TurpinL/radial-sequencer/KiCad/Radial Sequencer Test Board 1/Radial Sequencer Test Board 1.kicad_pcb

## KiCad design KiCad/Radial Sequencer Test Board 1/Radial Sequencer Test Board 1.kicad_pcb (2025-02-18)

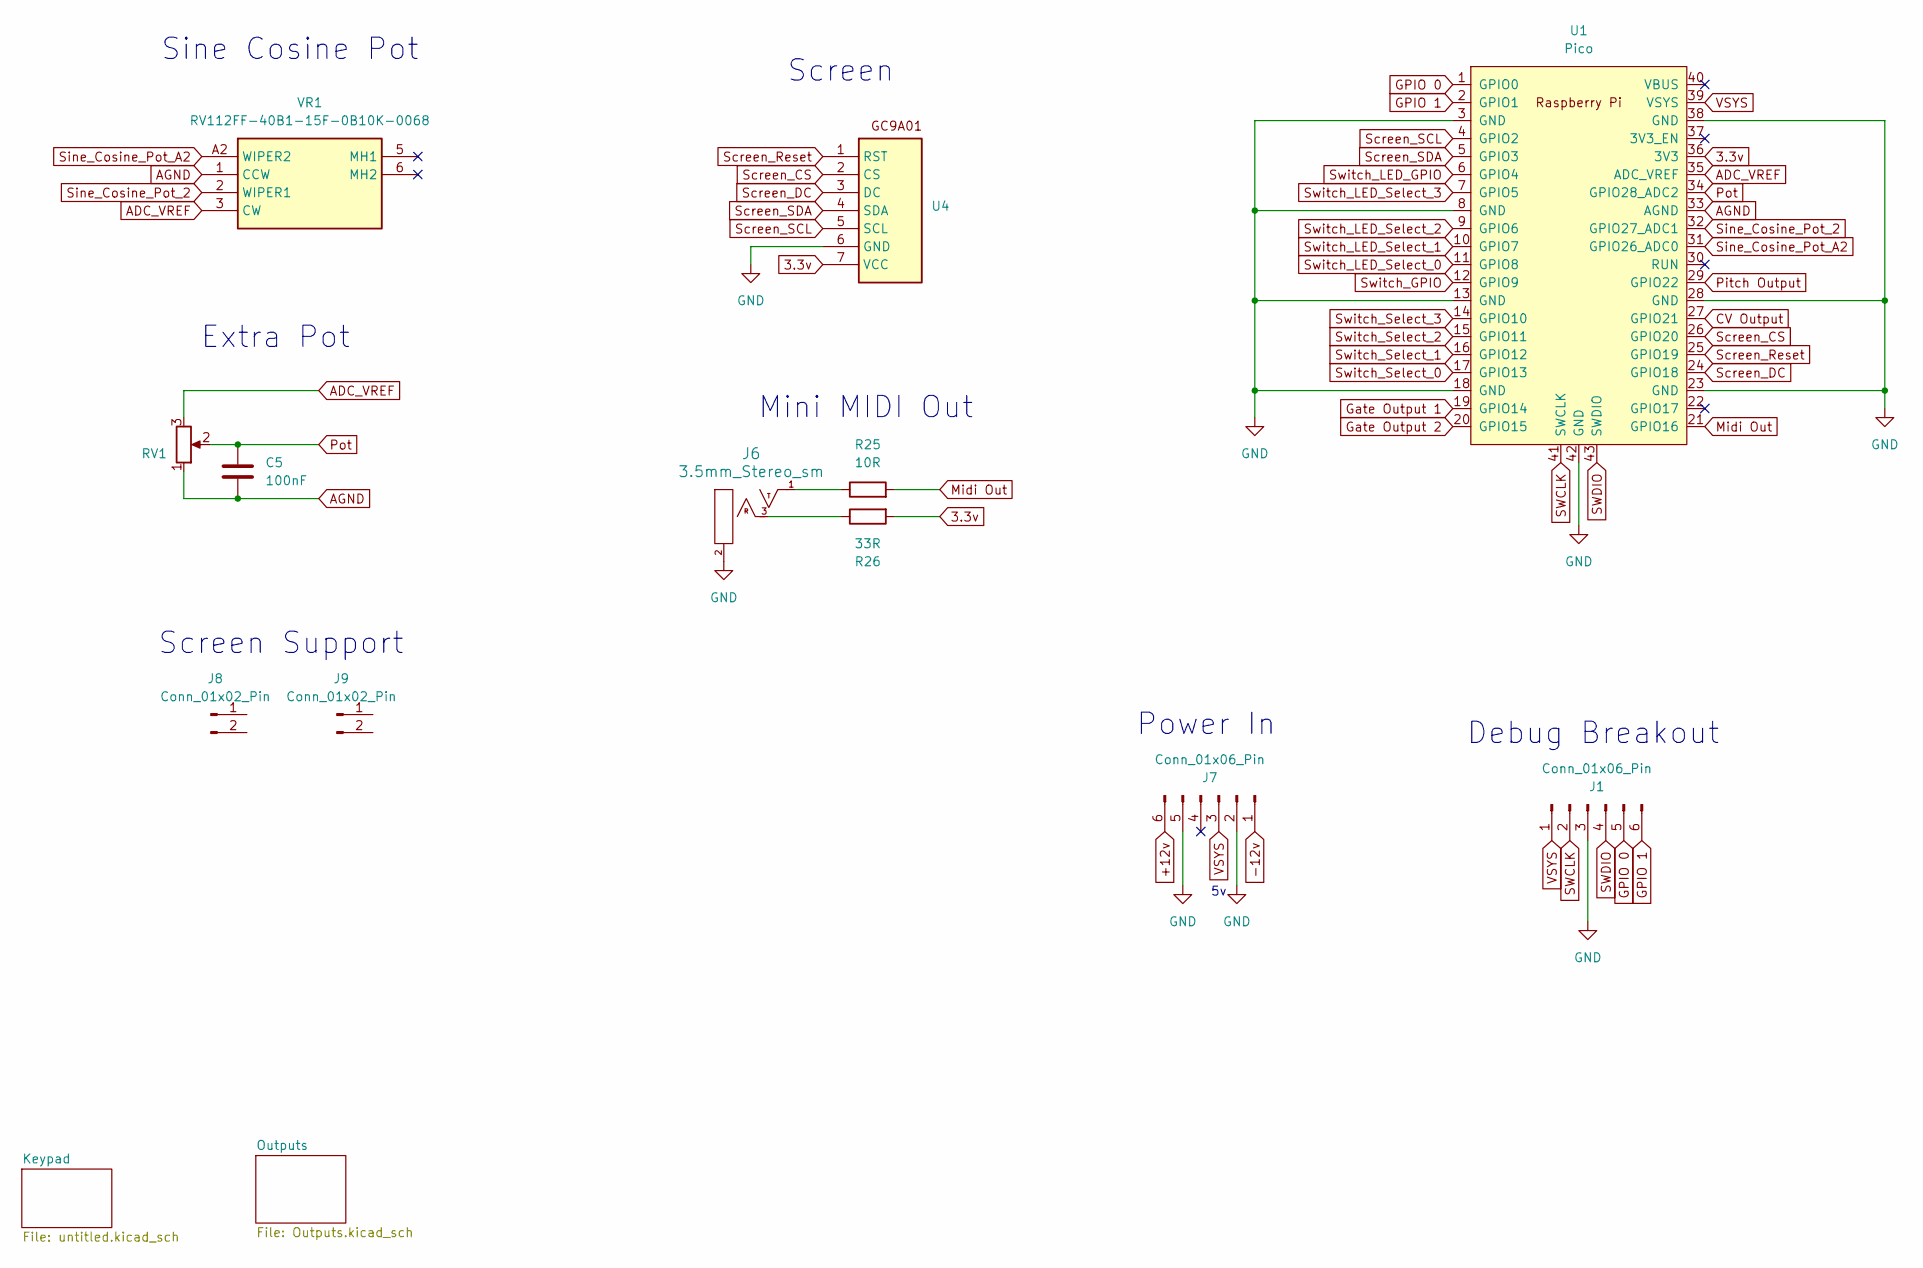
[picture p1: schematic Radial Sequencer Test Board 1.kicad_sch]

Parts:
C5: 100nF; C_0805_2012Metric_Pad1.18x1.45mm_HandSolder
J1, J7: Conn_01x06_Pin; PinHeader_1x06_P2.54mm_Vertical
J6: 3.5mm_Stereo_sm; EighthInch_Stereo_PJ366ST; Part Number WQP-WQP518MA
J8, J9: Conn_01x02_Pin; PinHeader_1x02_P2.00mm_Vertical
R25: 10R; R_0805_2012Metric_Pad1.20x1.40mm_HandSolder
R26: 33R; R_0805_2012Metric_Pad1.20x1.40mm_HandSolder
RV1: R_Potentiometer; Potentiometer_Alpha_RD901F-40-00D_Single_Vertical
U1: Pico; RPi_Pico_SMD_TH
U4: PinHeader_1x07_P2.00mm_Vertical
VR1: RV112FF-40B1-15F-0B10K-0068; RV112FF40B115F0B20K0068; Mouser Part Number 317-1240FF-15F-0B20K

Connections:
3.3v: R26.2, U1.36 (3V3), U4.7 (VCC); also elsewhere on the board
+12v: J7.6; also elsewhere on the board
-12v: J7.1; also elsewhere on the board
ADC_VREF: RV1.3, U1.35 (ADC_VREF), VR1.3 (CW)
AGND: C5.2, RV1.1, U1.33 (AGND), VR1.1 (CCW)
CV Output: U1.27 (GPIO21); also elsewhere on the board
GND: J1.3, J6.2 (SHEILD), J7.2, J7.5, U1.3 (GND), U1.8 (GND), U1.13 (GND), U1.18 (GND), U1.23 (GND), U1.28 (GND), U1.38 (GND), U1.42 (GND), U4.6 (GND); also elsewhere on the board
GPIO 0: J1.5, U1.1 (GPIO0)
GPIO 1: J1.6, U1.2 (GPIO1)
Gate Output 1: U1.19 (GPIO14); also elsewhere on the board
Gate Output 2: U1.20 (GPIO15); also elsewhere on the board
Midi Out: R25.2, U1.21 (GPIO16)
unnamed: J6.1 (SIG), R25.1
unnamed: J6.3 (SW), R26.1
Pitch Output: U1.29 (GPIO22); also elsewhere on the board
Pot: C5.1, RV1.2, U1.34 (GPIO28_ADC2)
SWCLK: J1.2, U1.41 (SWCLK)
SWDIO: J1.4, U1.43 (SWDIO)
Screen_CS: U1.26 (GPIO20), U4.2 (CS)
Screen_DC: U1.24 (GPIO18), U4.3 (DC)
Screen_Reset: U1.25 (GPIO19), U4.1 (RST)
Screen_SCL: U1.4 (GPIO2), U4.5 (SCL)
Screen_SDA: U1.5 (GPIO3), U4.4 (SDA)
Sine_Cosine_Pot_2: U1.32 (GPIO27_ADC1), VR1.2 (WIPER1)
Sine_Cosine_Pot_A2: U1.31 (GPIO26_ADC0), VR1.A2 (WIPER2)
Switch_GPIO: U1.12 (GPIO9); also elsewhere on the board
Switch_LED_GPIO: U1.6 (GPIO4); also elsewhere on the board
Switch_LED_Select_0: U1.11 (GPIO8); also elsewhere on the board
Switch_LED_Select_1: U1.10 (GPIO7); also elsewhere on the board
Switch_LED_Select_2: U1.9 (GPIO6); also elsewhere on the board
Switch_LED_Select_3: U1.7 (GPIO5); also elsewhere on the board
Switch_Select_0: U1.17 (GPIO13); also elsewhere on the board
Switch_Select_1: U1.16 (GPIO12); also elsewhere on the board
Switch_Select_2: U1.15 (GPIO11); also elsewhere on the board
Switch_Select_3: U1.14 (GPIO10); also elsewhere on the board
VSYS: J1.1, J7.3, U1.39 (VSYS)

Notes on the sheet:
Power In
Mini MIDI Out
Debug Breakout
Screen
Screen Support
Extra Pot
Sine Cosine Pot

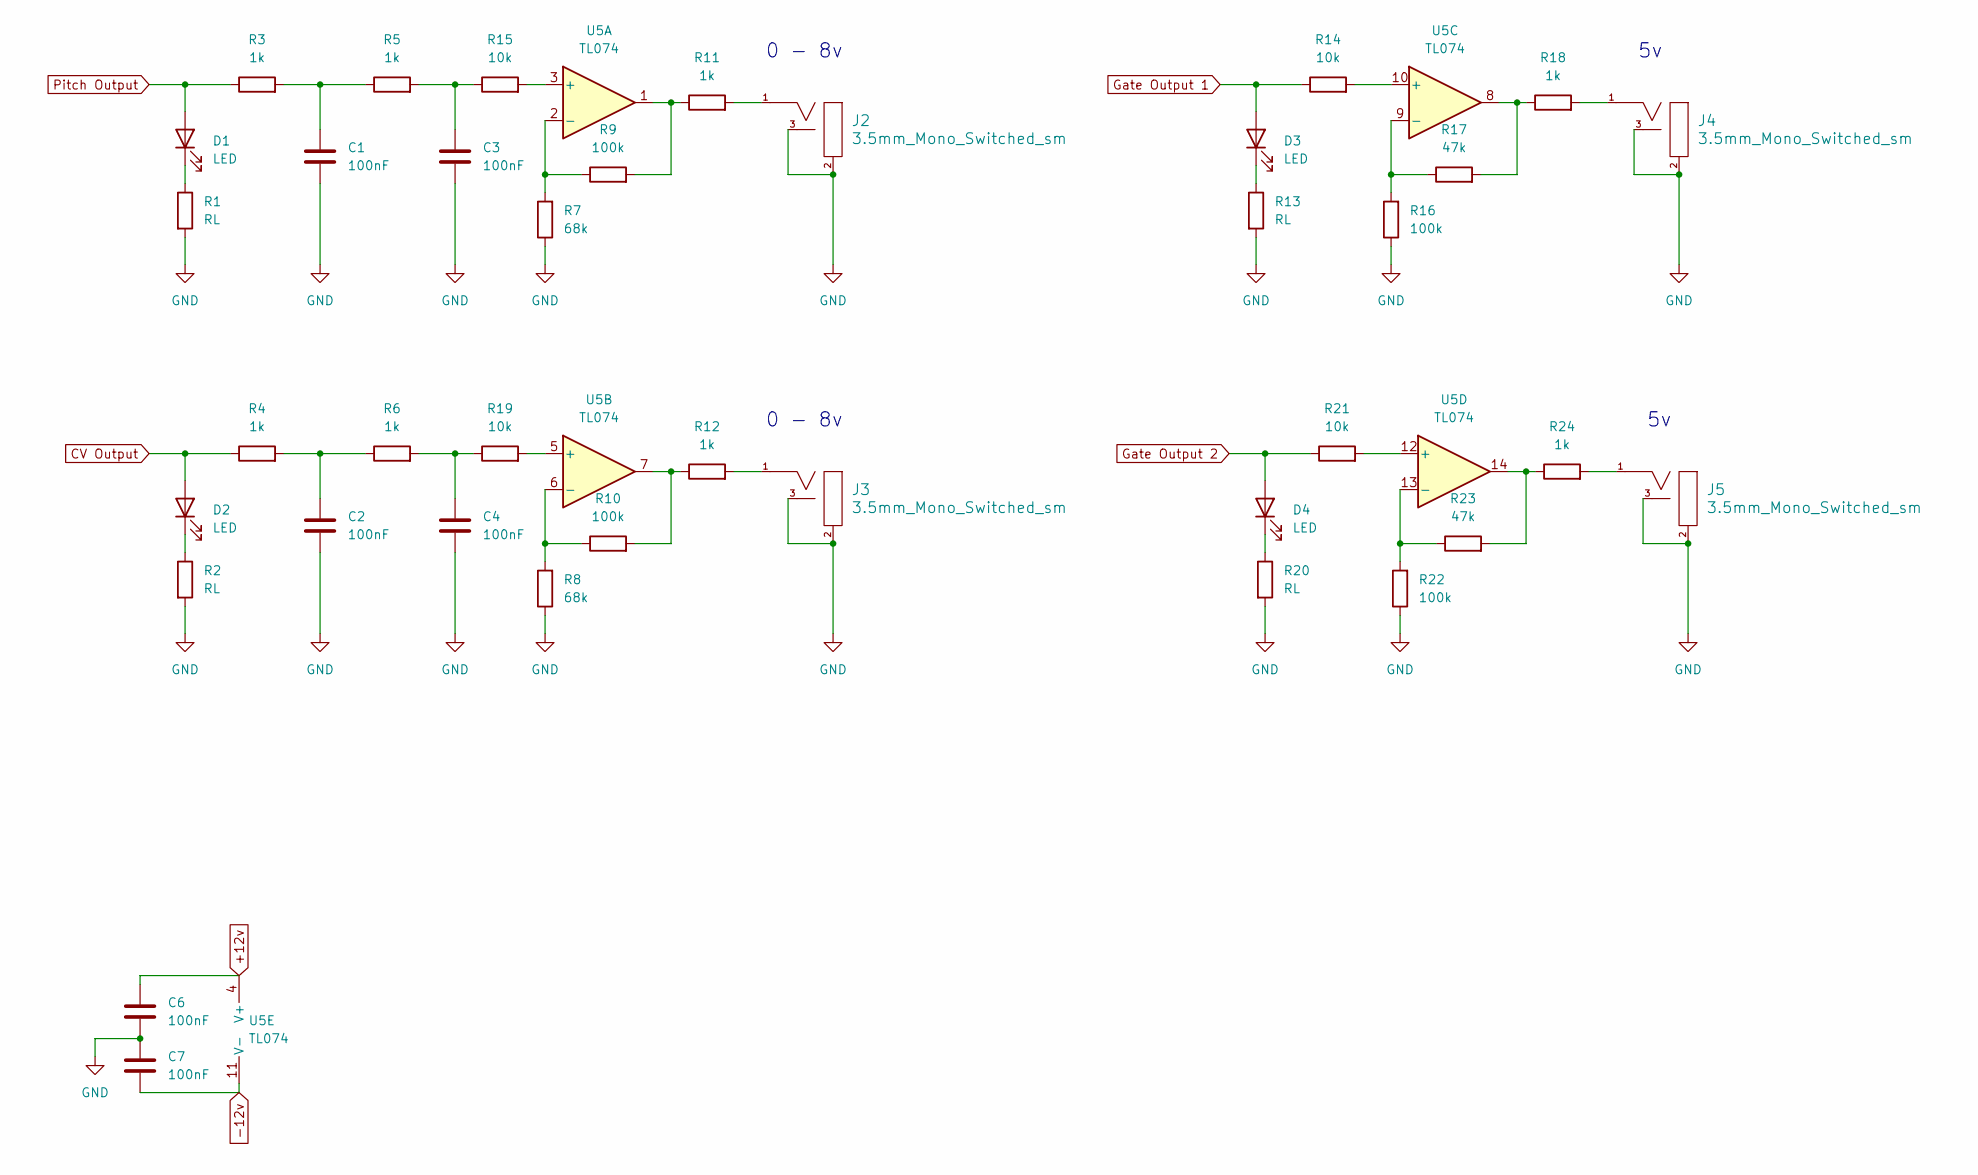
[picture p2: schematic Outputs.kicad_sch]

Parts:
C1, C2, C3, C4, C6, C7: 100nF; C_0805_2012Metric_Pad1.18x1.45mm_HandSolder
D1, D2, D3, D4: LED; LED_D3.0mm
J2, J3, J4, J5: 3.5mm_Mono_Switched_sm; EighthInch_PJ398SM; Part Number WQP-WQP518MA
R1, R2, R13, R20: RL; R_0805_2012Metric_Pad1.20x1.40mm_HandSolder
R3, R4, R5, R6, R11, R12, R18, R24: 1k; R_0805_2012Metric_Pad1.20x1.40mm_HandSolder
R7, R8: 68k; R_0805_2012Metric_Pad1.20x1.40mm_HandSolder
R9, R10, R16, R22: 100k; R_0805_2012Metric_Pad1.20x1.40mm_HandSolder
R14, R15, R19, R21: 10k; R_0805_2012Metric_Pad1.20x1.40mm_HandSolder
R17, R23: 47k; R_0805_2012Metric_Pad1.20x1.40mm_HandSolder
U5: TL074; SOIC-14_3.9x8.7mm_P1.27mm

Connections:
+12v: C6.1, U5.4 (V+); also elsewhere on the board
-12v: C7.2, U5.11 (V-); also elsewhere on the board
CV Output: D2.2 (A), R4.1; also elsewhere on the board
GND: C1.2, C2.2, C3.2, C4.2, C6.2, C7.1, J2.2 (SHEILD), J2.3 (SW), J3.2 (SHEILD), J3.3 (SW), J4.2 (SHEILD), J4.3 (SW), J5.2 (SHEILD), J5.3 (SW), R1.2, R2.2, R7.1, R8.1, R13.2, R16.1, R20.2, R22.1; also elsewhere on the board
Gate Output 1: D3.2 (A), R14.1; also elsewhere on the board
Gate Output 2: D4.2 (A), R21.1; also elsewhere on the board
unnamed: C1.1, R3.2, R5.1
unnamed: C2.1, R4.2, R6.1
unnamed: C3.1, R5.2, R15.1
unnamed: C4.1, R6.2, R19.1
unnamed: D1.1 (K), R1.1
unnamed: D2.1 (K), R2.1
unnamed: D3.1 (K), R13.1
unnamed: D4.1 (K), R20.1
unnamed: J2.1 (SIG), R11.2
unnamed: J3.1 (SIG), R12.2
unnamed: J4.1 (SIG), R18.2
unnamed: J5.1 (SIG), R24.2
unnamed: R10.2, R12.1, U5.7
unnamed: R9.2, R11.1, U5.1
unnamed: R17.2, R18.1, U5.8
unnamed: R23.2, R24.1, U5.14
unnamed: R15.2, U5.3 (+)
unnamed: R7.2, R9.1, U5.2 (-)
unnamed: R19.2, U5.5 (+)
unnamed: R8.2, R10.1, U5.6 (-)
unnamed: R14.2, U5.10 (+)
unnamed: R16.2, R17.1, U5.9 (-)
unnamed: R21.2, U5.12 (+)
unnamed: R22.2, R23.1, U5.13 (-)
Pitch Output: D1.2 (A), R3.1; also elsewhere on the board

Notes on the sheet:
0 - 8v

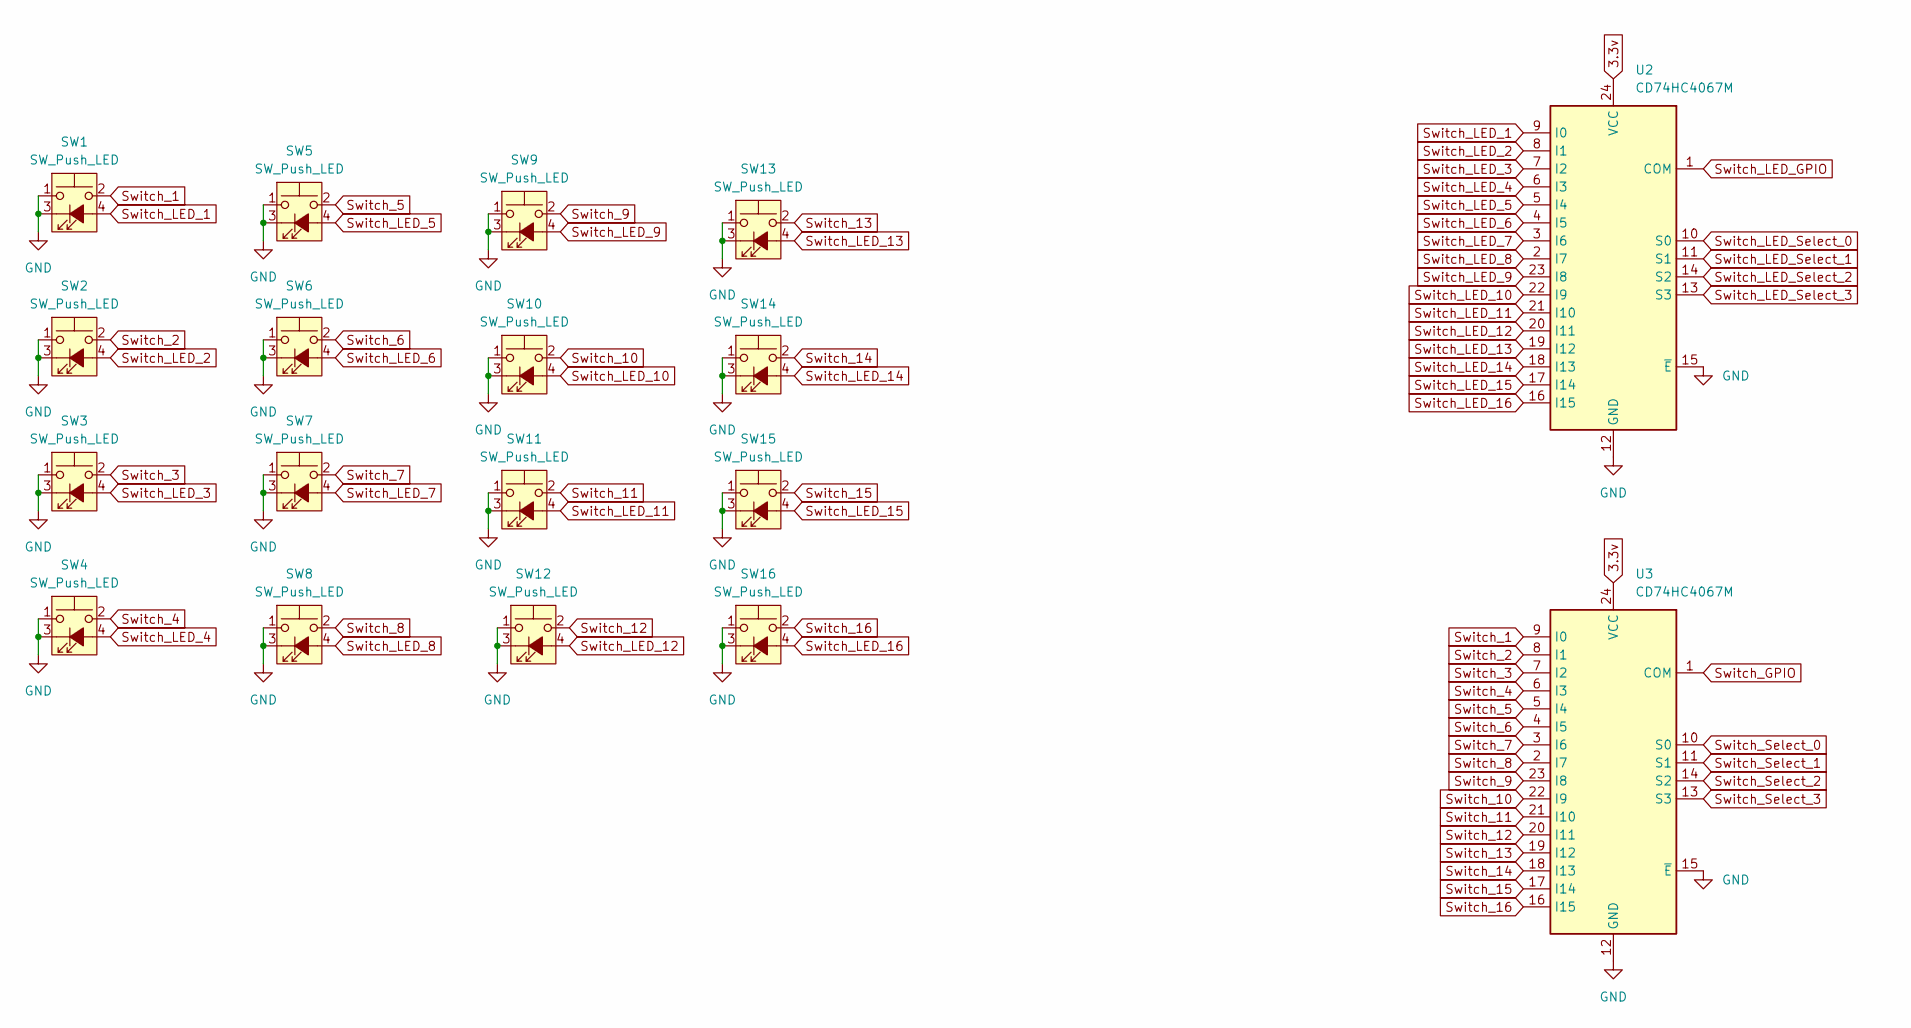
[picture p3: schematic untitled.kicad_sch]

Parts:
SW1, SW2, SW3, SW4, SW5, SW6, SW7, SW8, SW9, SW10, SW11, SW12, SW13, SW14, SW15, SW16: SW_Push_LED; Low_Profile_LED_Button
U2, U3: CD74HC4067M; SOIC-24W_7.5x15.4mm_P1.27mm

Connections:
3.3v: U2.24 (VCC), U3.24 (VCC); also elsewhere on the board
GND: SW1.1, SW1.3 (K), SW2.1, SW2.3 (K), SW3.1, SW3.3 (K), SW4.1, SW4.3 (K), SW5.1, SW5.3 (K), SW6.1, SW6.3 (K), SW7.1, SW7.3 (K), SW8.1, SW8.3 (K), SW9.1, SW9.3 (K), SW10.1, SW10.3 (K), SW11.1, SW11.3 (K), SW12.1, SW12.3 (K), SW13.1, SW13.3 (K), SW14.1, SW14.3 (K), SW15.1, SW15.3 (K), SW16.1, SW16.3 (K), U2.12 (GND), U2.15 (~E), U3.12 (GND), U3.15 (~E); also elsewhere on the board
Switch_1: SW1.2, U3.9 (I0)
Switch_2: SW2.2, U3.8 (I1)
Switch_3: SW3.2, U3.7 (I2)
Switch_4: SW4.2, U3.6 (I3)
Switch_5: SW5.2, U3.5 (I4)
Switch_6: SW6.2, U3.4 (I5)
Switch_7: SW7.2, U3.3 (I6)
Switch_8: SW8.2, U3.2 (I7)
Switch_9: SW9.2, U3.23 (I8)
Switch_10: SW10.2, U3.22 (I9)
Switch_11: SW11.2, U3.21 (I10)
Switch_12: SW12.2, U3.20 (I11)
Switch_13: SW13.2, U3.19 (I12)
Switch_14: SW14.2, U3.18 (I13)
Switch_15: SW15.2, U3.17 (I14)
Switch_16: SW16.2, U3.16 (I15)
Switch_GPIO: U3.1 (COM); also elsewhere on the board
Switch_LED_1: SW1.4 (A), U2.9 (I0)
Switch_LED_2: SW2.4 (A), U2.8 (I1)
Switch_LED_3: SW3.4 (A), U2.7 (I2)
Switch_LED_4: SW4.4 (A), U2.6 (I3)
Switch_LED_5: SW5.4 (A), U2.5 (I4)
Switch_LED_6: SW6.4 (A), U2.4 (I5)
Switch_LED_7: SW7.4 (A), U2.3 (I6)
Switch_LED_8: SW8.4 (A), U2.2 (I7)
Switch_LED_9: SW9.4 (A), U2.23 (I8)
Switch_LED_10: SW10.4 (A), U2.22 (I9)
Switch_LED_11: SW11.4 (A), U2.21 (I10)
Switch_LED_12: SW12.4 (A), U2.20 (I11)
Switch_LED_13: SW13.4 (A), U2.19 (I12)
Switch_LED_14: SW14.4 (A), U2.18 (I13)
Switch_LED_15: SW15.4 (A), U2.17 (I14)
Switch_LED_16: SW16.4 (A), U2.16 (I15)
Switch_LED_GPIO: U2.1 (COM); also elsewhere on the board
Switch_LED_Select_0: U2.10 (S0); also elsewhere on the board
Switch_LED_Select_1: U2.11 (S1); also elsewhere on the board
Switch_LED_Select_2: U2.14 (S2); also elsewhere on the board
Switch_LED_Select_3: U2.13 (S3); also elsewhere on the board
Switch_Select_0: U3.10 (S0); also elsewhere on the board
Switch_Select_1: U3.11 (S1); also elsewhere on the board
Switch_Select_2: U3.14 (S2); also elsewhere on the board
Switch_Select_3: U3.13 (S3); also elsewhere on the board

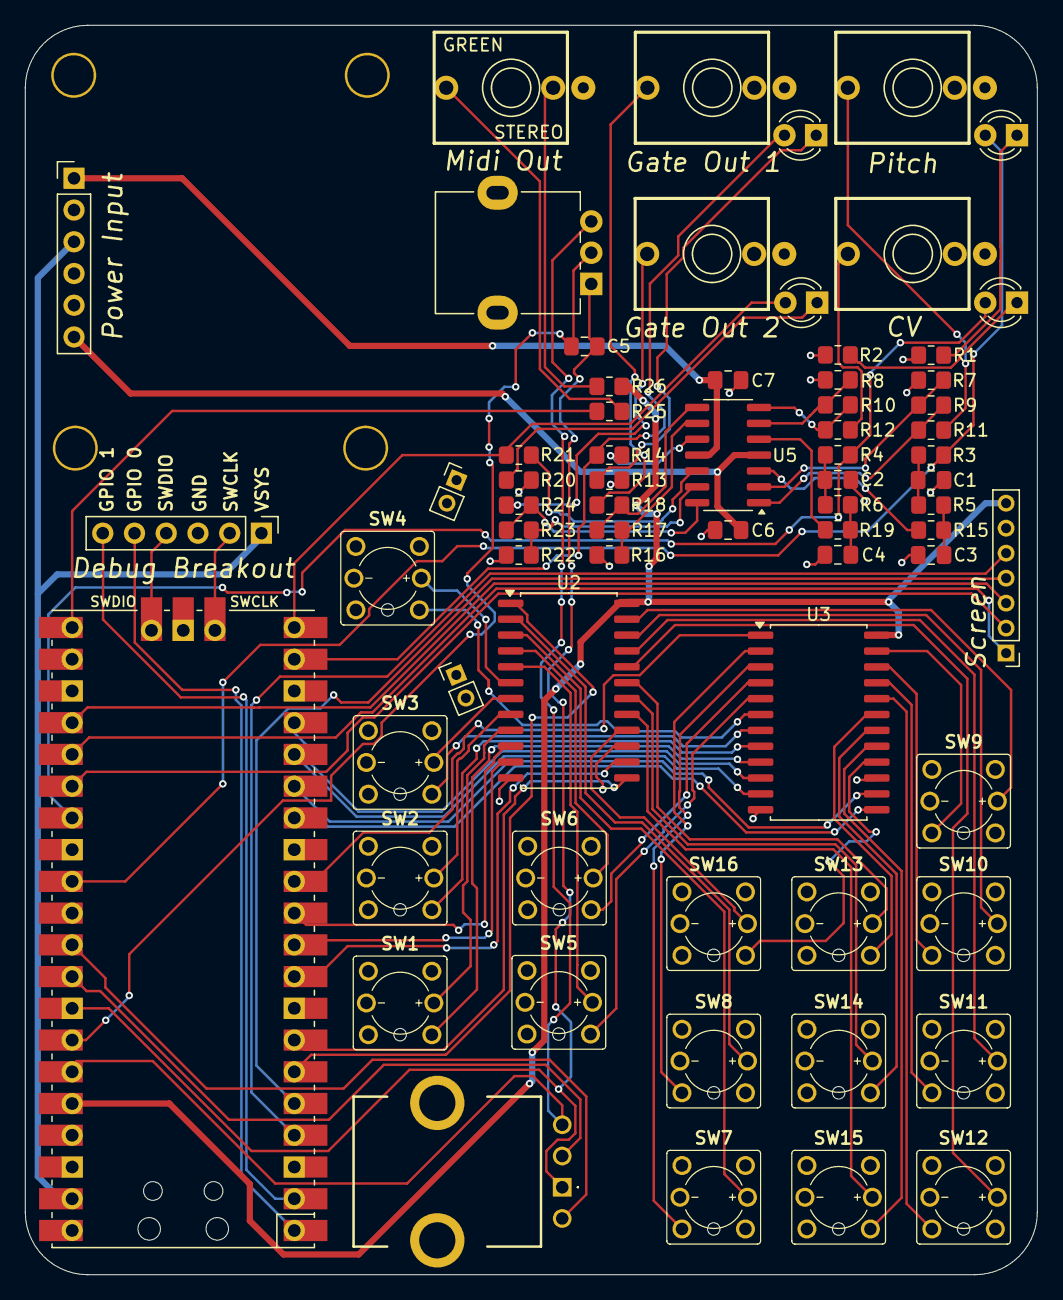
[picture p4: board Radial Sequencer Test Board 1.kicad_pcb from above]

Board: 2 copper layers, 81.0 x 100.0 mm, 69 parts (0 on the bottom side), 92 nets.
