TurpinL/radial-sequencer/(commit log)

2024-08-19 Better button handling
2024-08-26 Gate handles held and skipped pulses Beat indicator improvements Gate and Pitch LEDs More buttons
    [Sequence.h, main.cpp]
2024-09-17 Implement pulse count and gate mode buttons
2024-11-12 Clone and Delete - Removed hysteresis because it was causing issues with deletion
    [Button.h, Sequence.h, main.cpp]
2025-01-04 Upgrade to Pico 2
    Buttons needed to be changed to pull-up to work around an bug with the pico 2
    [Button.h, main.cpp]
2025-02-18 Big commit, oops * Prototype PCB v1 * Midi output * Move * Picoprobe
    [Outputs.kicad_sch, Radial Sequencer Test Board 1.kicad_pcb, Radial Sequencer Test Board 1.kicad_sch, untitled.kicad_sch]
2025-03-03 Multiplexed Buttons and button LEDs
2025-04-09 Change how the stage value is drawn
2025-05-10 Extract pulse pip button handling logic to it's own class
2025-05-16 Refactoring, separating button handlers out into their own files
2025-05-19 Refactoring: Polymorphic button handling
2025-06-28 Move stage to it's own file
2025-06-30 Bugfix: BPM was jittering, causing gate to jitter on and off at the thresholds causing midi notes to be constantly retriggered
    [main.cpp]
2025-07-16 Piano based pitch selection indicator
